RootRoot-SSVV/rover/3d modeli/Main body.stl

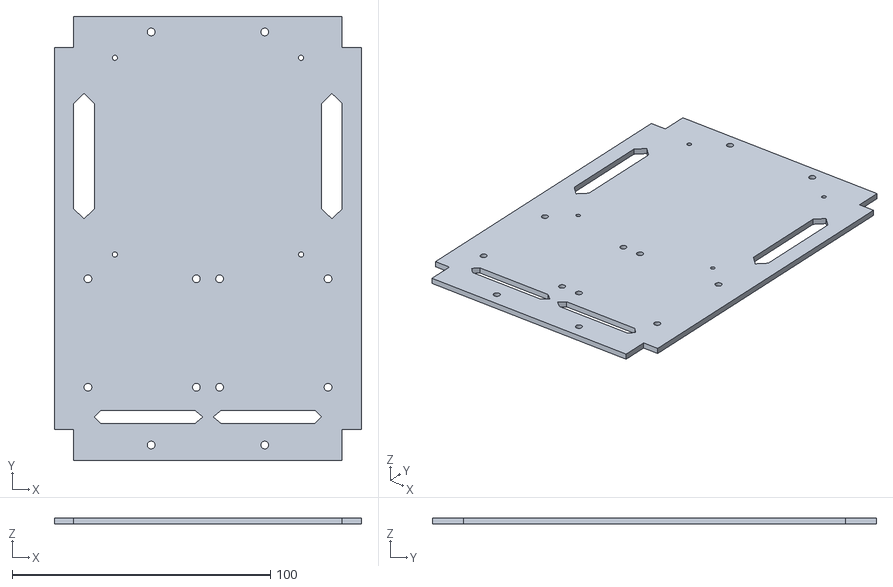
[picture p25: CAD file, 2024-02-25]
3d modeli/Main body.stl
119.0 x 172.0 x 2.50
