RootRoot-SSVV/rover/3d modeli/Ultrasonic roof.stl

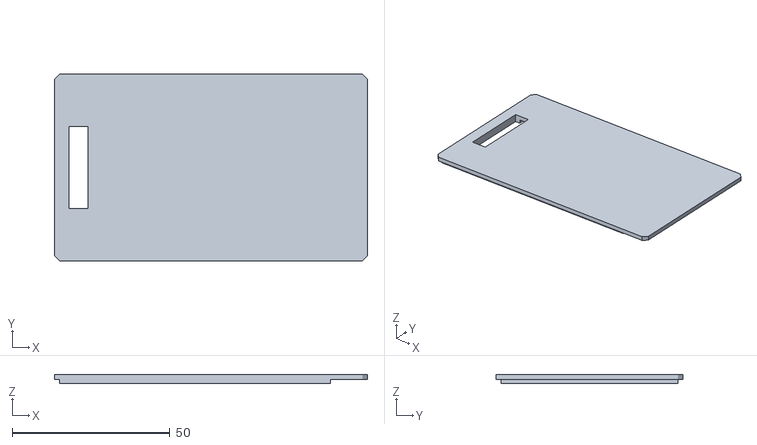
[picture p26: CAD file, 2024-02-25]
3d modeli/Ultrasonic roof.stl
99.2 x 59.2 x 3.00
