RootRoot-SSVV/rover/3d modeli/holder up.stl

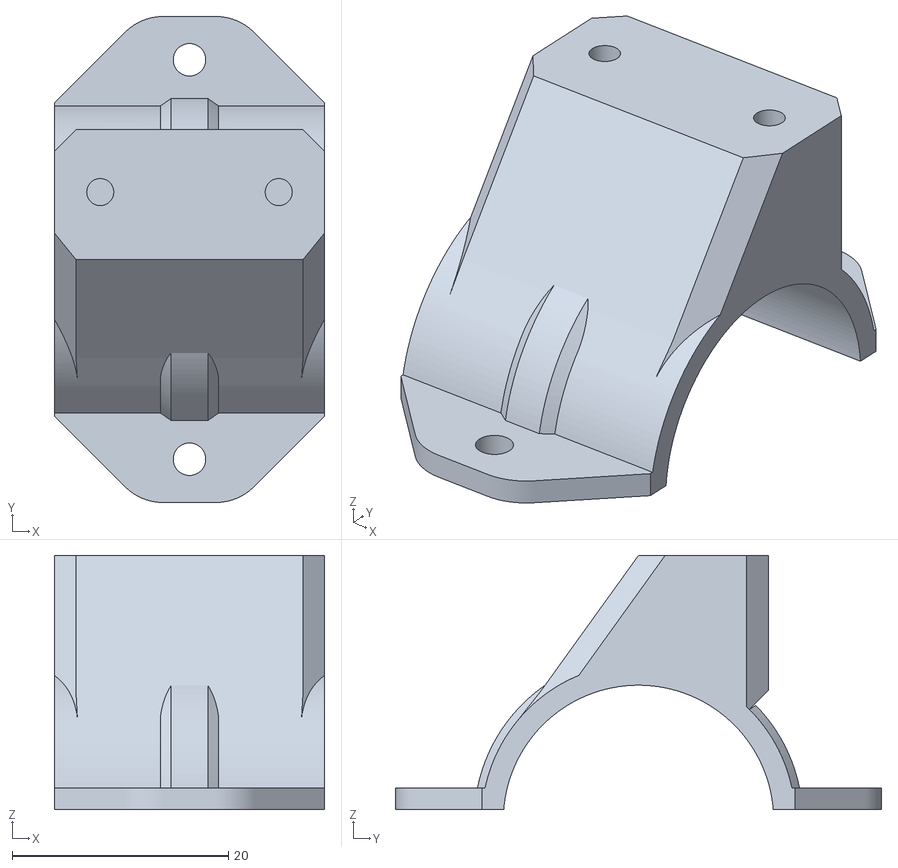
[picture p27: CAD file, 2024-02-25]
3d modeli/holder up.stl
25.0 x 44.9 x 23.5
