RootRoot-SSVV/rover/3d modeli/Ultrasonic body.stl

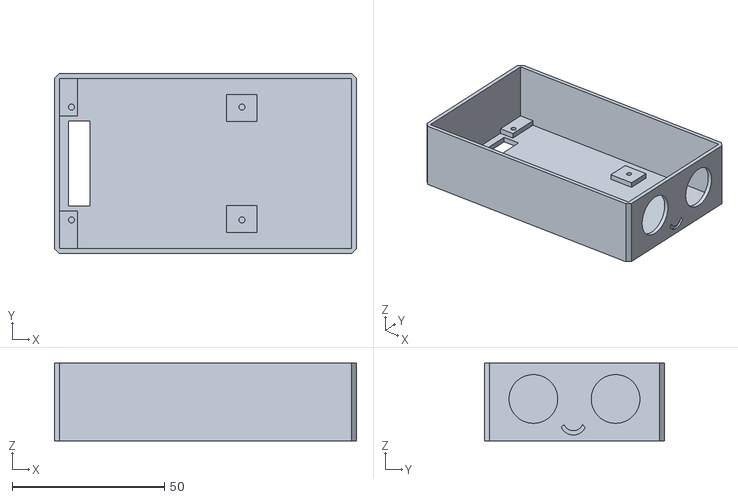
[picture p28: CAD file, 2024-02-25]
3d modeli/Ultrasonic body.stl
99.2 x 59.2 x 25.6
