RootRoot-SSVV/rover/3d modeli/Arch.stl

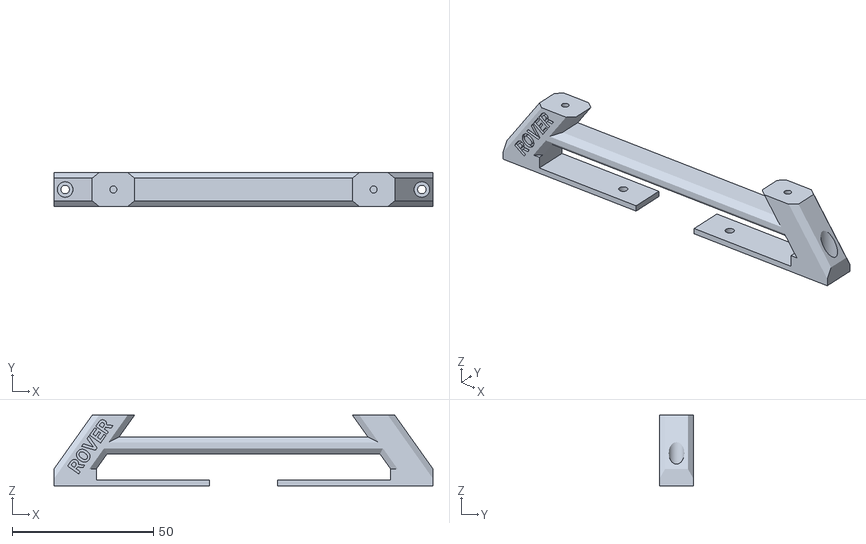
[picture p29: CAD file, 2024-02-25]
3d modeli/Arch.stl
134.0 x 12.0 x 25.0
