RootRoot-SSVV/rover/3d modeli/Matrix body.stl

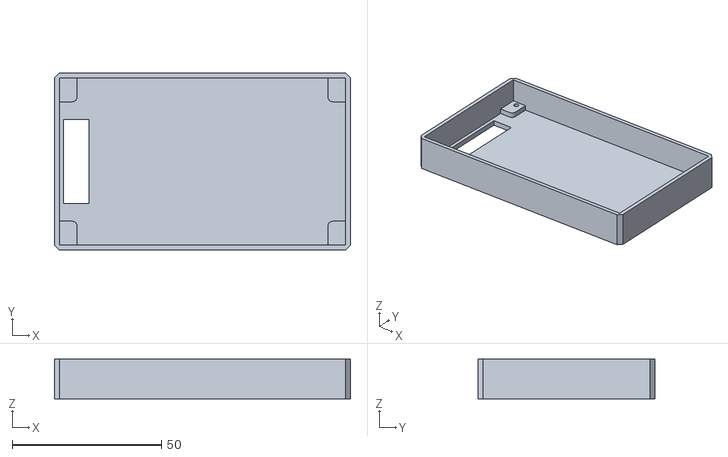
[picture p30: CAD file, 2024-02-25]
3d modeli/Matrix body.stl
99.2 x 59.2 x 13.4
