RootRoot-SSVV/rover/3d modeli/holder down.stl

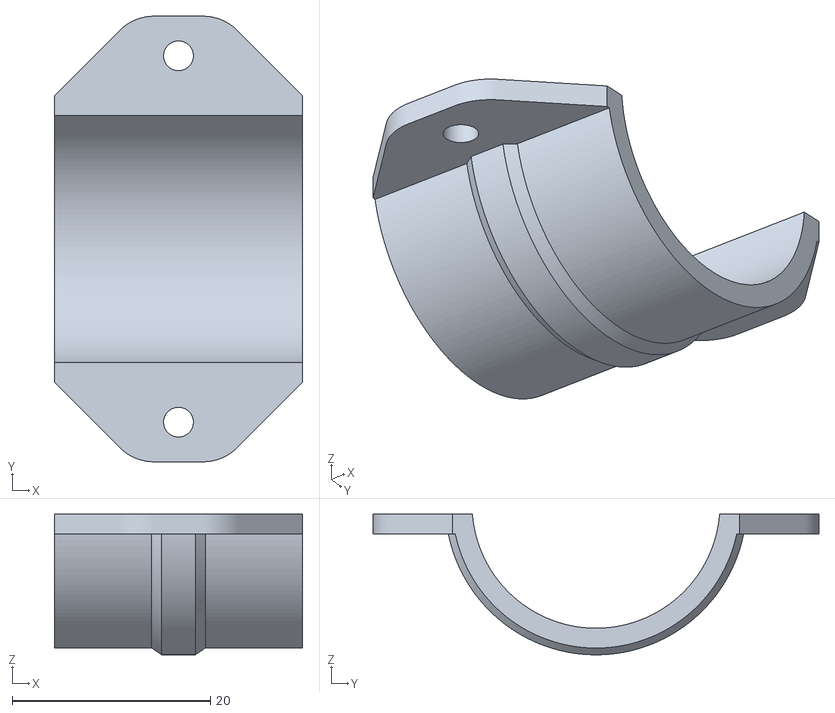
[picture p31: CAD file, 2024-02-25]
3d modeli/holder down.stl
25.0 x 44.9 x 14.2
