RootRoot-SSVV/rover/3d modeli/Matrix roof.stl

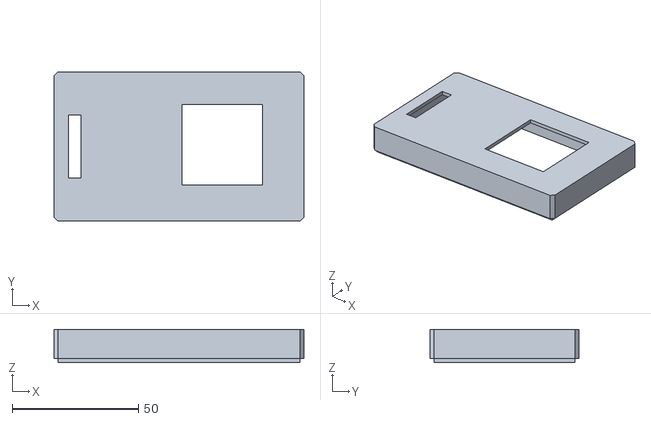
[picture p32: CAD file, 2024-02-25]
3d modeli/Matrix roof.stl
99.2 x 59.2 x 13.1
