RootRoot-SSVV/rover/3d modeli/Demo roof.stl

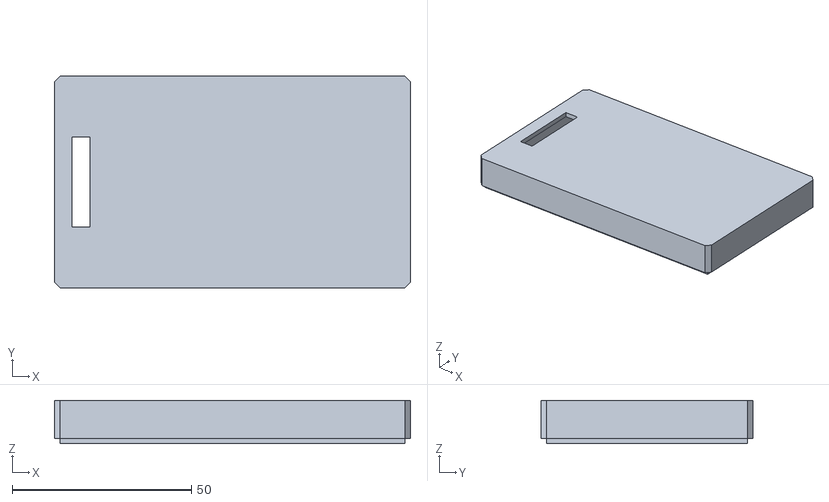
[picture p33: CAD file, 2024-02-25]
3d modeli/Demo roof.stl
99.2 x 59.2 x 12.0
