RootRoot-SSVV/rover/3d modeli/Roof.stl

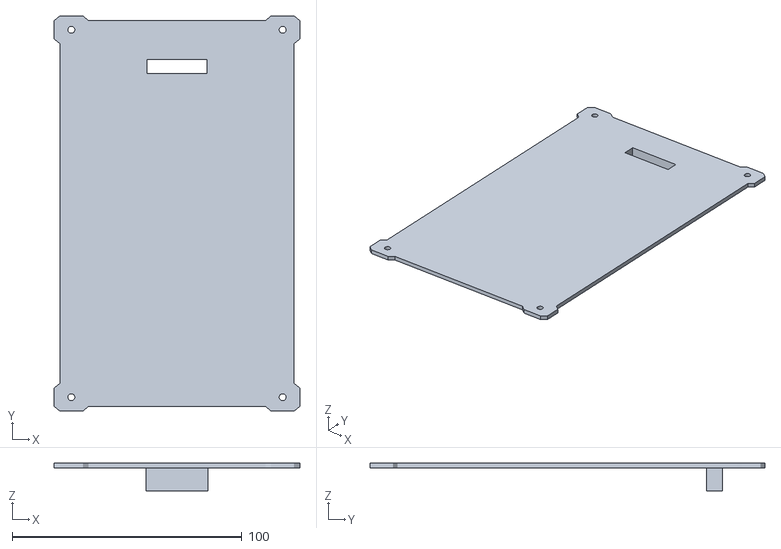
[picture p34: CAD file, 2024-02-25]
3d modeli/Roof.stl
107.0 x 172.0 x 12.0
