RootRoot-SSVV/rover/(list of files, cad)

Other CAD files:
3d modeli/Demo body.stl
